torinrory/12V-5V-Buck-Converter/BOM.csv

Item | Reference | Qty | Value | Description | Package / KiCad Footprint | Manufacturer | Manufacturer Part Number (MPN) | Alternate MPN | Key Specifications & Engineering Notes
1 | U1 | 1 | TPS54302 | IC REG BUCK SYNC 5V 3A SOT23-6 | Package_TO_SOT_SMD:SOT-23-6 | Texas Instruments | TPS54302DDCR | TPS54302DDCT | 4.5V-28V Input, 3A Continuous Output, 400kHz Synchronous Step-Down Converter (integrated 85mOhm/40mOhm FETs)
2 | L1 | 1 | 10uH | Shielded Molded Power Inductor 10uH 4.5A | Inductor_SMD:L_Bourns_SRP7028A_7.3x6.6mm | Bourns | SRP7028A-100M | SRP7050TA-100M | 10uH +/-20%, I_rms = 4.5A, I_sat = 8.0A, DCR = 53.5mOhm max, 7.3x6.6mm SMD
3 | C1 | 1 | 10uF | Input Bulk Ceramic Capacitor 10uF 50V X7R | Capacitor_SMD:C_1206_3216Metric_Pad1.33x1.80mm_HandSolder | Samsung Electro-Mechanics | CL31B106KBHNNNE | GRM31CR71H106KA12L | 10uF +/-10%, 50V (exceeds TI 35V min recommendation), X7R Dielectric, 1206
4 | C2, C3 | 2 | 0.1uF | HF Input Bypass & Bootstrap Capacitor 0.1uF 50V X7R | Capacitor_SMD:C_0805_2012Metric_Pad1.18x1.45mm_HandSolder | Yageo | CC0805KRX7R9BB104 | CL21B104KBCNNNC | 0.1uF (100nF) +/-10%, 50V, X7R Dielectric, 0805 (C2 = VIN HF Bypass, C3 = BOOT-SW Charge Pump)
5 | C4, C5 | 2 | 22uF | Output Filter Ceramic Capacitor 22uF 25V X5R/X7R | Capacitor_SMD:C_1206_3216Metric_Pad1.33x1.80mm_HandSolder | Murata Electronics | GRM31CR61E226KE15L | CL31A226KAHNNNE | 22uF +/-10%, 25V (minimizes DC bias derating at 5V), X5R/X7R Dielectric, 1206 (44uF nominal total)
6 | C6 | 1 | 75pF | Feedforward Compensation Capacitor 75pF 50V C0G/NP0 | Capacitor_SMD:C_0805_2012Metric_Pad1.18x1.45mm_HandSolder | Murata Electronics | GRM2165C1H750JA01D | CC0805JRNPO9BN750 | 75pF +/-5%, 50V, C0G/NP0 Dielectric, 0805 (boosts control loop phase margin at crossover)
7 | R1 | 1 | 49.9 | Control Loop Injection Resistor 49.9 Ohm 1% | Resistor_SMD:R_0805_2012Metric_Pad1.20x1.40mm_HandSolder | Yageo | RC0805FR-0749R9L | CRCW080549R9FKTA | 49.9 Ohm +/-1%, 0.125W (1/8W), Thick Film, 0805 (Bode plot / stability test injection point)
8 | R2 | 1 | 100k | Upper Feedback Divider Resistor 100k Ohm 1% | Resistor_SMD:R_0805_2012Metric_Pad1.20x1.40mm_HandSolder | Yageo | RC0805FR-07100KL | CRCW0805100KFKEA | 100k Ohm +/-1%, 0.125W (1/8W), Thick Film, 0805 (sets Vout = 5.08V with R3 = 13.3k)
9 | R3 | 1 | 13.3k | Lower Feedback Divider Resistor 13.3k Ohm 1% | Resistor_SMD:R_0805_2012Metric_Pad1.20x1.40mm_HandSolder | Yageo | RC0805FR-0713K3L | CRCW080513K3FKEA | 13.3k Ohm +/-1%, 0.125W (1/8W), Thick Film, 0805 (sets Vout = 5.08V with R2 = 100k)
10 | R4 | 1 | 511k | Upper UVLO Enable Divider Resistor 511k Ohm 1% | Resistor_SMD:R_0805_2012Metric_Pad1.20x1.40mm_HandSolder | Yageo | RC0805FR-07511KL | CRCW0805511KFKEA | 511k Ohm +/-1%, 0.125W (1/8W), Thick Film, 0805 (sets Vin UVLO start/stop thresholds)
11 | R5 | 1 | 105k | Lower UVLO Enable Divider Resistor 105k Ohm 1% | Resistor_SMD:R_0805_2012Metric_Pad1.20x1.40mm_HandSolder | Yageo | RC0805FR-07105KL | CRCW0805105KFKEA | 105k Ohm +/-1%, 0.125W (1/8W), Thick Film, 0805 (sets Vin UVLO start/stop thresholds)
12 | R6 | 1 | 1k | LED Current Limiting Resistor 1k Ohm 1% | Resistor_SMD:R_0805_2012Metric_Pad1.20x1.40mm_HandSolder | Yageo | RC0805FR-071KL | CRCW08051K00FKEA | 1k Ohm +/-1%, 0.125W (1/8W), Thick Film, 0805 (limits D1 indicator LED current to ~3mA at 5V)
13 | D1 | 1 | Green | 5V Power Good Indicator LED Green 0805 | LED_SMD:LED_0805_2012Metric_Pad1.15x1.40mm_HandSolder | Lite-On | LTST-C170KGKT | 150080GS75000 | Green (571nm) SMD LED, Vf = 2.0V typ, 0805 (Note: Align cathode mark with Pad 1 / GND on PCB)
14 | J1, J2 | 2 | Vin_12V, Vout_5V_3A | 2-Pos Screw Terminal Block 5.08mm Pitch | TerminalBlock_Phoenix:TerminalBlock_Phoenix_MKDS-1 | 5-2-5.08_1x02_P5.08mm_Horizontal | Phoenix Contact | 1715721 | OSTTC022162 | MKDS 1,5/ 2-5,08, 2-Pin 5.08mm Pitch, Through-Hole, Rated 17.5A / 400V, 14-26 AWG
15 | TP1, TP2, TP3, TP4 | 4 | Vin, SW, Vout, GND | PCB Test Point Loop (or Probe Bare PTH Directly) | TestPoint:TestPoint_THTPad_D1.5mm_Drill0.7mm | Keystone Electronics | 5005 | DNP (Bare Pad) | OptionalMiniature THT Test Point for 0.7mm (0.028in) drill, or leave unpopulated to probe plated holes directly
