torinrory/12V-5V-Buck-Converter/12V_5V_Buck_Converter.pdf

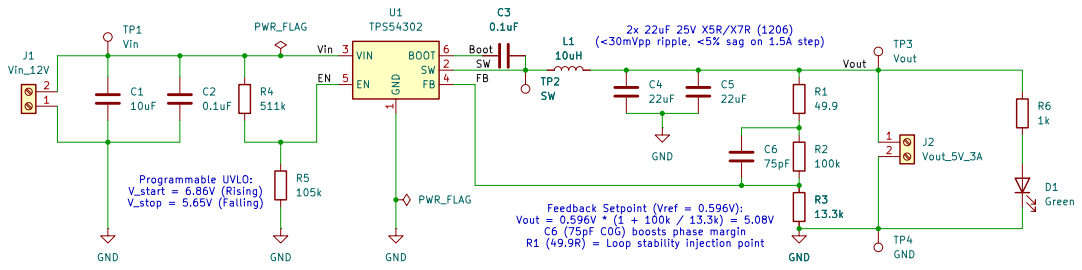
[picture p3: page 1]

Peak efficiency ~95%
f_sw = 400 kHz
Output: 5.0V @ 3A Max
Input: 8V-24V DC (12V Nominal)
Torin Hamilton
Sheet: /
File: 12V_5V_Buck_Converter.kicad_sch
Title: 12V-to-5V 3A Synchronous Buck Converter (TPS54302)

Size: A4 | Rev: 1.0
KiCad E.D.A. 10.0.8 | Id: 1/1
