torinrory/12V-5V-Buck-Converter/12V_5V_Buck_Converter.kicad_pcb

## KiCad design 12V_5V_Buck_Converter.kicad_pcb (2026-11-11)

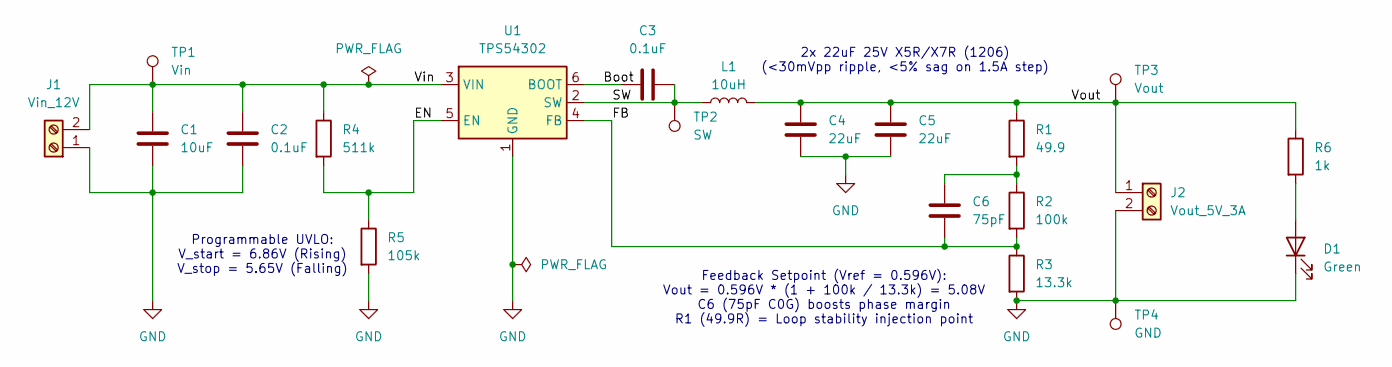
[picture p4: schematic 12V_5V_Buck_Converter.kicad_sch, 12V-to-5V 3A Synchronous Buck Converter (TPS54302)]

Parts:
C1: 10uF; C_1206_3216Metric_Pad1.33x1.80mm_HandSolder
C2, C3: 0.1uF; C_0805_2012Metric_Pad1.18x1.45mm_HandSolder
C4, C5: 22uF; C_1206_3216Metric_Pad1.33x1.80mm_HandSolder
C6: 75pF; C_0805_2012Metric_Pad1.18x1.45mm_HandSolder
D1: Green; LED_0805_2012Metric_Pad1.15x1.40mm_HandSolder
J1: Vin_12V; TerminalBlock_Phoenix_MKDS-1,5-2-5.08_1x02_P5.08mm_Horizont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
J2: Vout_5V_3A; TerminalBlock_Phoenix_MKDS-1,5-2-5.08_1x02_P5.08mm_Horizont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
L1: 10uH; L_Bourns_SRP7028A_7.3x6.6mm
R1: 49.9; R_0805_2012Metric_Pad1.20x1.40mm_HandSolder
R2: 100k; R_0805_2012Metric_Pad1.20x1.40mm_HandSolder
R3: 13.3k; R_0805_2012Metric_Pad1.20x1.40mm_HandSolder
R4: 511k; R_0805_2012Metric_Pad1.20x1.40mm_HandSolder
R5: 105k; R_0805_2012Metric_Pad1.20x1.40mm_HandSolder
R6: 1k; R_0805_2012Metric_Pad1.20x1.40mm_HandSolder
TP1: Vin; TestPoint_THTPad_D1.5mm_Drill0.7mm
TP2: SW; TestPoint_THTPad_D1.5mm_Drill0.7mm
TP3: Vout; TestPoint_THTPad_D1.5mm_Drill0.7mm
TP4: GND; TestPoint_THTPad_D1.5mm_Drill0.7mm
U1: TPS54302; SOT-23-6

Connections:
/Boot: C3.1, U1.6 (BOOT)
/EN: R4.2, R5.1, U1.5 (EN)
/FB: C6.2, R2.2, R3.1, U1.4 (FB)
/SW: C3.2, L1.1, TP2.1 (1_1), U1.2 (SW)
/Vin: C1.1, C2.1, J1.2, R4.1, TP1.1 (1_1), U1.3 (VIN)
/Vout: C4.2, C5.1, J2.1, L1.2, R1.1, R6.1, TP3.1 (1_1)
GND: C1.2, C2.2, C4.1, C5.2, D1.1 (K), J1.1, J2.2, R3.2, R5.2, TP4.1 (1_1), U1.1 (GND)
unnamed: C6.1, R1.2, R2.1
unnamed: D1.2 (A), R6.2

Notes on the sheet:
Programmable UVLO: V_start = 6.86V (Rising) V_stop = 5.65V (Falling)
2x 22uF 25V X5R/X7R (1206) (<30mVpp ripple, <5% sag on 1.5A step)
Feedback Setpoint (Vref = 0.596V): Vout = 0.596V * (1 + 100k / 13.3k) = 5.08V C6 (75pF C0G) boosts phase margin R1 (49.9R) = Loop stability injection point

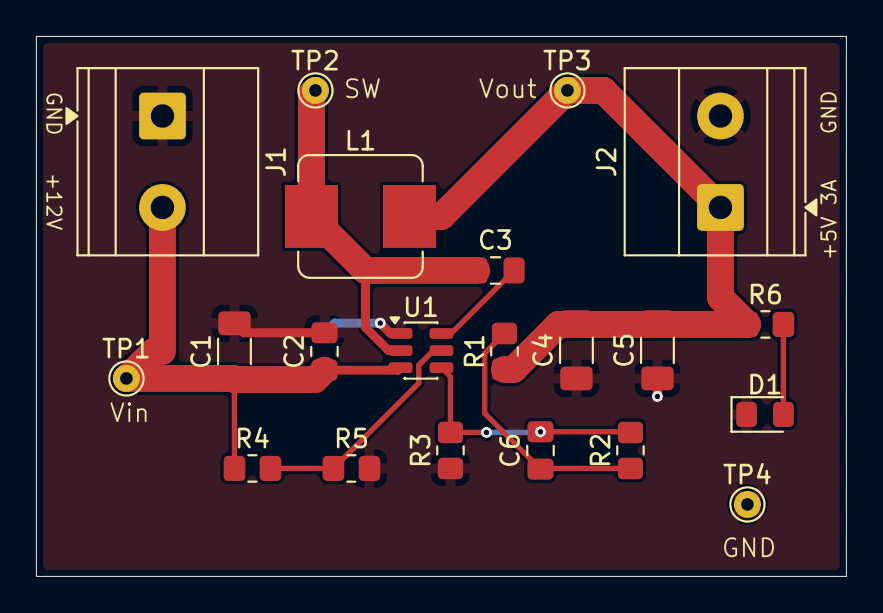
[picture p5: board 12V_5V_Buck_Converter.kicad_pcb from above]

Board: 2 copper layers, 45.0 x 30.0 mm, 21 parts (0 on the bottom side), 9 nets.
